deanperk/Fan_Controller/README.md

# Fan_Controller
Solar Enclosure Heating and Cooling fan
