deanperk/Fan_Controller/Fan Controller/Battery Cooling/Fan Controller PCA/Fan Controller TH/Fan Controller PCA Archive/IMG_20161119_0002.pdf

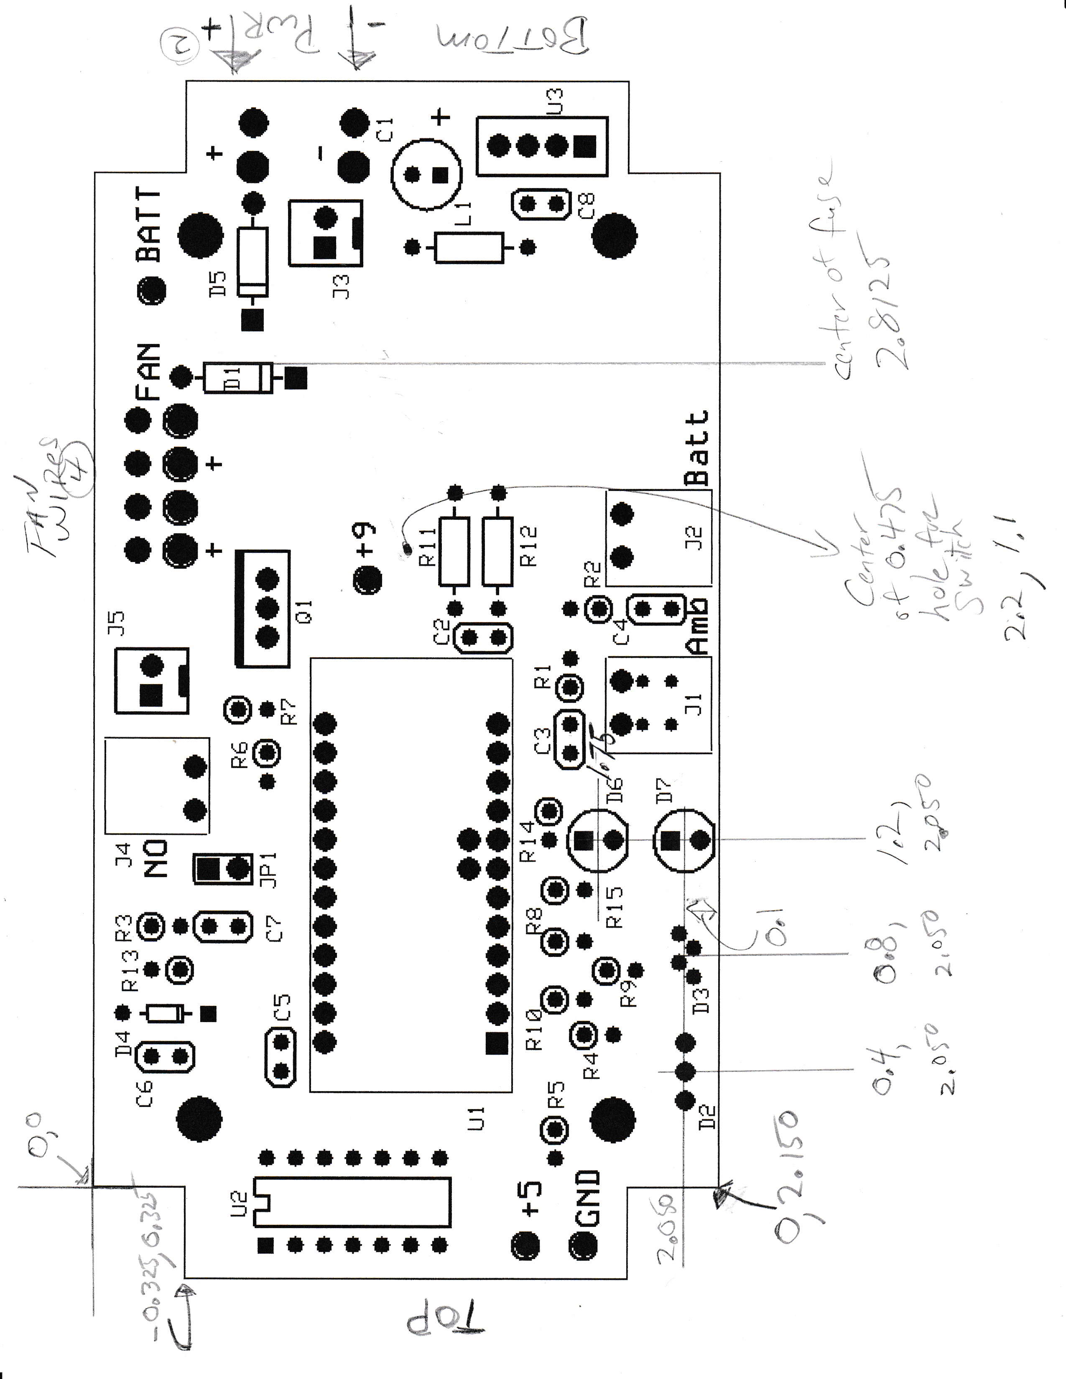
[picture p1: page 1]
