deanperk/Fan_Controller/Fan Controller/Battery Cooling/Fan Controller PCA/Fan Controller TH/Fan Controller PCA Archive/IMG_20161120_0001.pdf

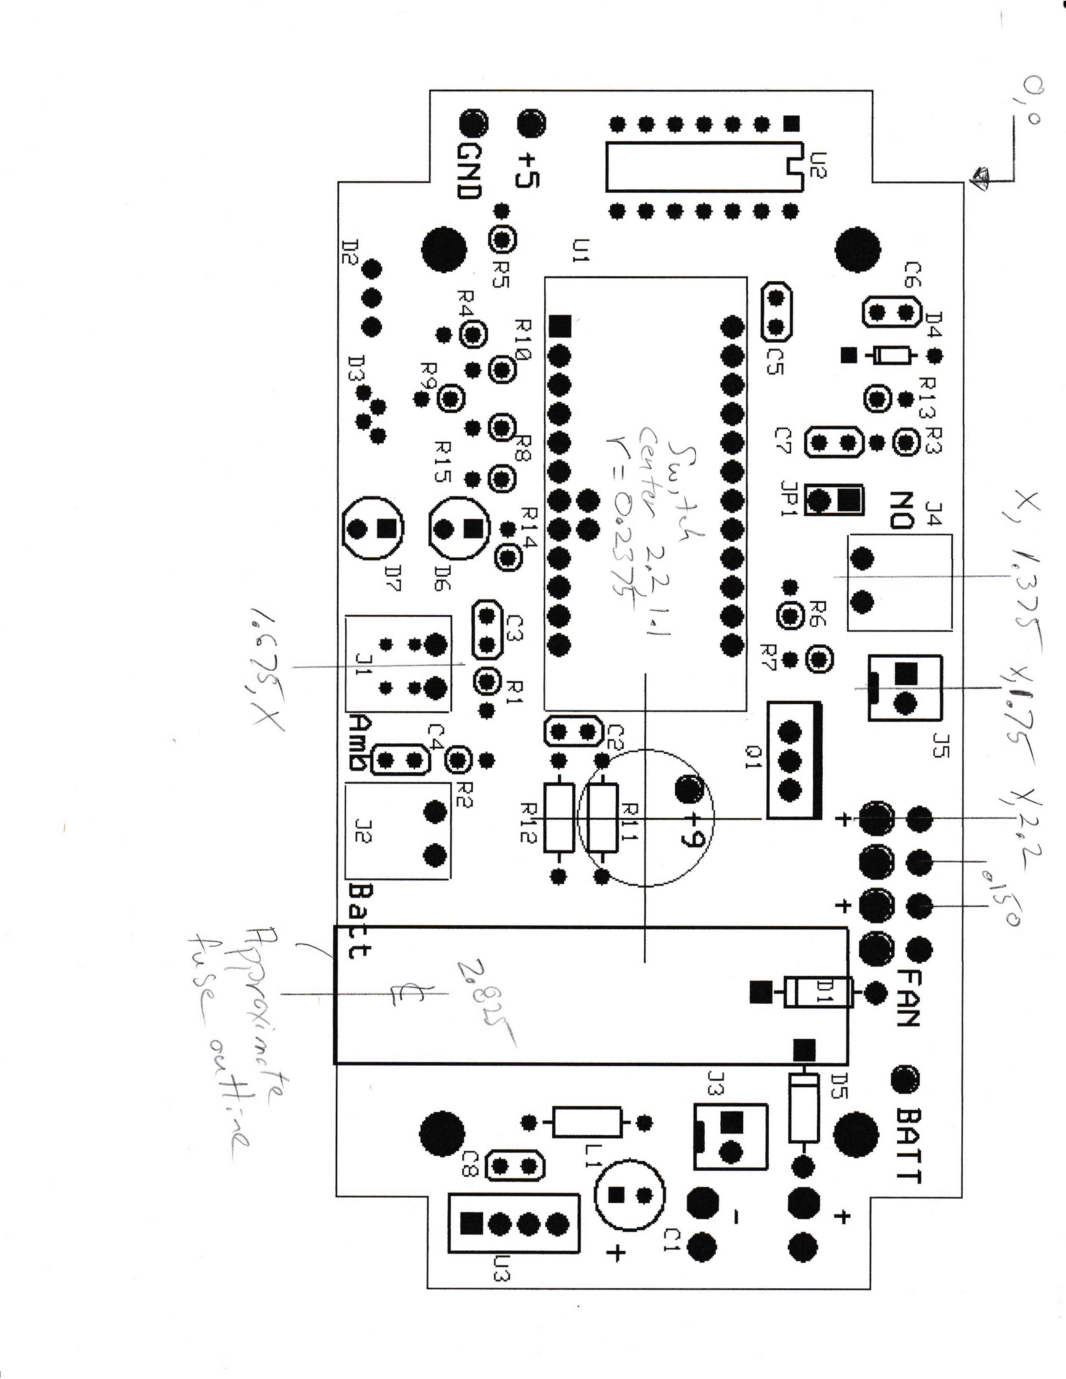
[picture p2: page 1]
