deanperk/Fan_Controller/Fan Controller/Battery Cooling/Fan Controller PCA/Fan Controller TH/Fan Controller PCA Archive/ENG_CD_103638_R2 (3).pdf

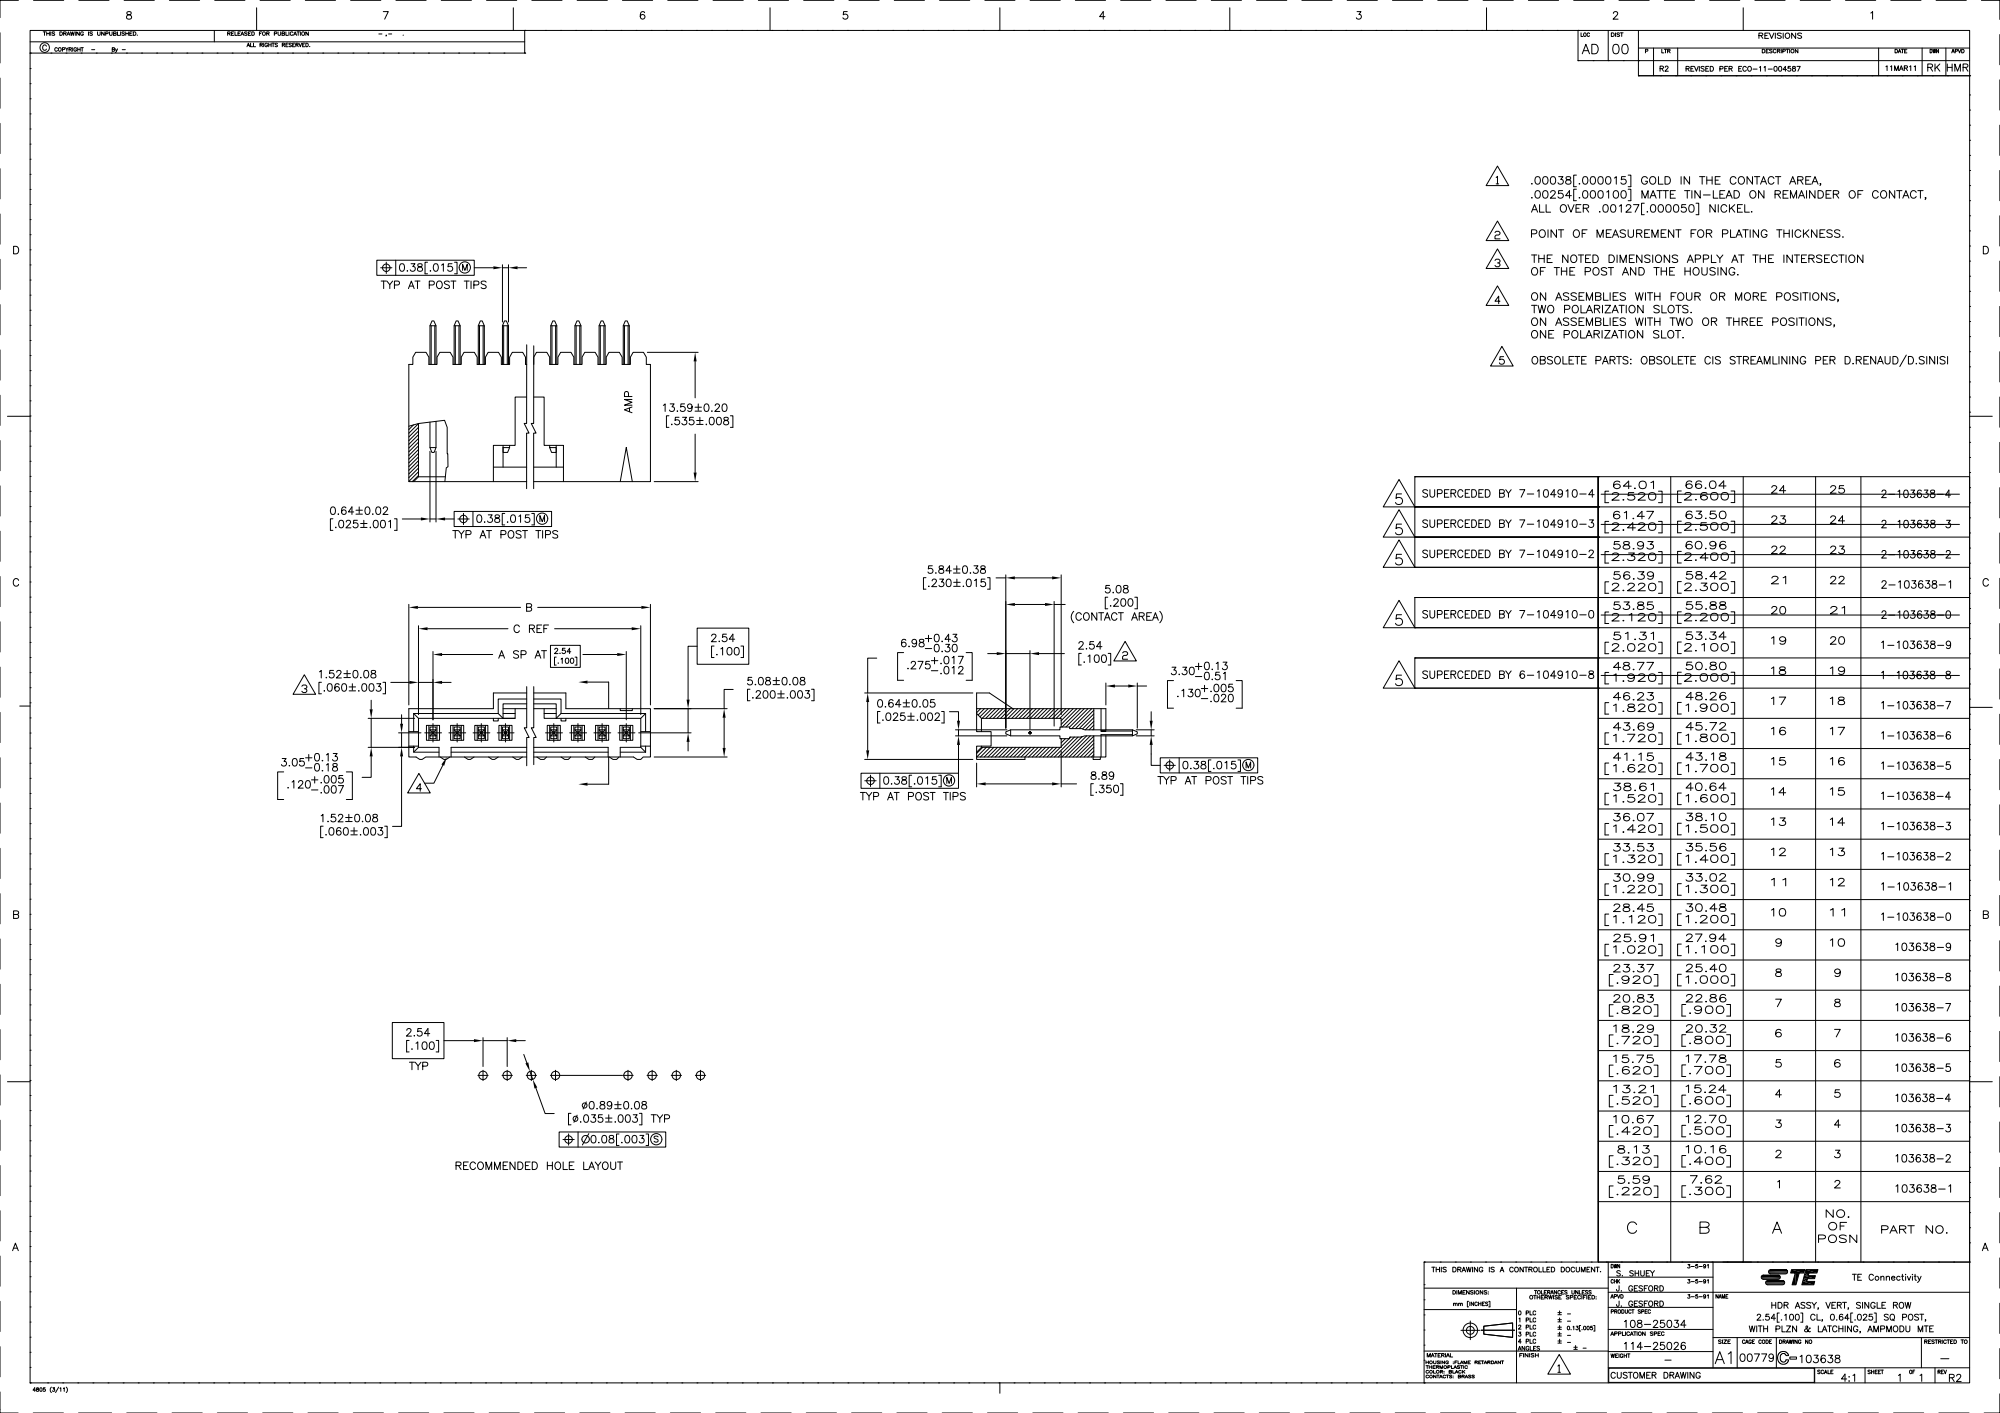
[picture p3: page 1]
