deanperk/Fan_Controller/(list of files, drawings)

Other design files:
Fan Controller/Battery Cooling/Fan Controller PCA/Fan Controller SMT/Fan Controller Processor Pkg.pcb
Fan Controller/Battery Cooling/Fan Controller PCA/Fan Controller SMT/Fan Controller SMT 2.pcb
Fan Controller/Battery Cooling/Fan Controller PCA/Fan Controller SMT/Fan Controller SMT 3.pcb
Fan Controller/Battery Cooling/Fan Controller PCA/Fan Controller SMT/Fan Controller SMT 3A.pcb
Fan Controller/Battery Cooling/Fan Controller PCA/Fan Controller SMT/Fan Controller SMT 3B.pcb
Fan Controller/Battery Cooling/Fan Controller PCA/Fan Controller SMT/FET.pcb
Fan Controller/Battery Cooling/Fan Controller PCA/Fan Controller SMT/TSOT23-5.pcb
Fan Controller/Battery Cooling/Fan Controller PCA/Fan Controller TH/Fan Controller Outline rev 8.pcb
Fan Controller/Battery Cooling/Fan Controller PCA/Fan Controller TH/Fan Controller PCA Archive/Alps Switch.pcb
Fan Controller/Battery Cooling/Fan Controller PCA/Fan Controller TH/Fan Controller PCA Archive/Fan Controller Outline Metro rev1 .pcb
Fan Controller/Battery Cooling/Fan Controller PCA/Fan Controller TH/Fan Controller PCA Archive/Fan Controller Outline rev 1.pcb
Fan Controller/Battery Cooling/Fan Controller PCA/Fan Controller TH/Fan Controller PCA Archive/Fan Controller Outline rev 2.pcb
Fan Controller/Battery Cooling/Fan Controller PCA/Fan Controller TH/Fan Controller PCA Archive/Fan Controller Outline rev 4.pcb
Fan Controller/Battery Cooling/Fan Controller PCA/Fan Controller TH/Fan Controller PCA Archive/Fan Controller Outline rev 5.pcb
Fan Controller/Battery Cooling/Fan Controller PCA/Fan Controller TH/Fan Controller PCA Archive/Fan Controller Outline rev 6.pcb
Fan Controller/Battery Cooling/Fan Controller PCA/Fan Controller TH/Fan Controller PCA Archive/Fan Controller Outline rev 7.pcb
Fan Controller/Battery Cooling/Fan Controller PCA/Fan Controller TH/Fan Controller PCA Archive/Fan Controller Outline.pcb
Fan Controller/Battery Cooling/Fan Controller PCA/Fan Controller TH/Fan Controller PCA Archive/Fan Controller TH.pcb
Fan Controller/Battery Cooling/Fan Controller PCA/Fan Controller TH/Fan Controller PCA Archive/Fan Controller Trinket.pcb
Fan Controller/Battery Cooling/Fan Controller PCA/Fan Controller TH/Fan Controller PCA Archive/Fan Controller.pcb
Fan Controller/Battery Cooling/Fan Controller PCA/Fan Controller TH/Fan Controller PCA Archive/Phoenix 2 Terminal.pcb
